labrax/esp32_room_sensors/case/esp32_case_501_preview.png

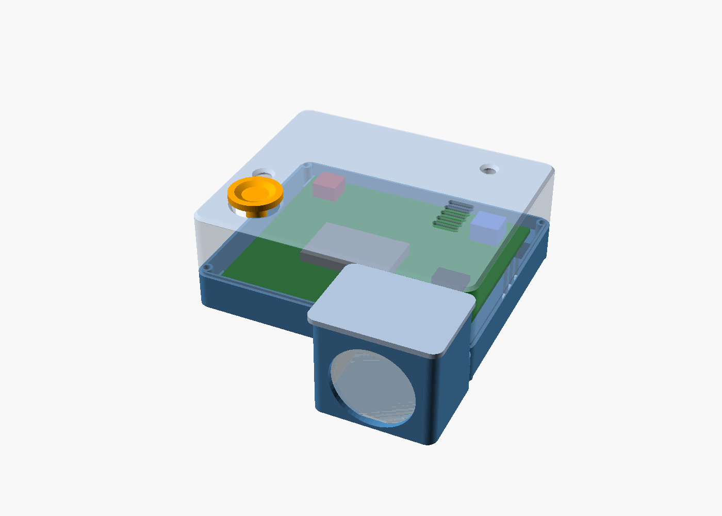
case/esp32_case_501_preview.png
