labrax/esp32_room_sensors/case/esp32_case_ext_preview.png

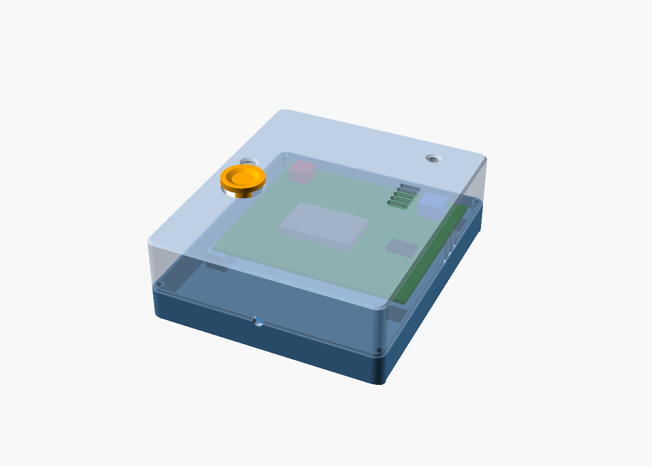
case/esp32_case_ext_preview.png
