labrax/esp32_room_sensors/case/esp32_case_lid_preview.png

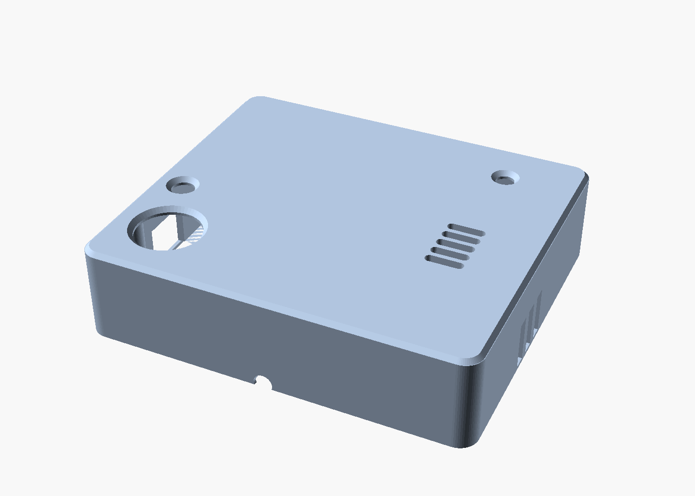
case/esp32_case_lid_preview.png
