labrax/esp32_room_sensors/case/esp32_case_plunger.stl

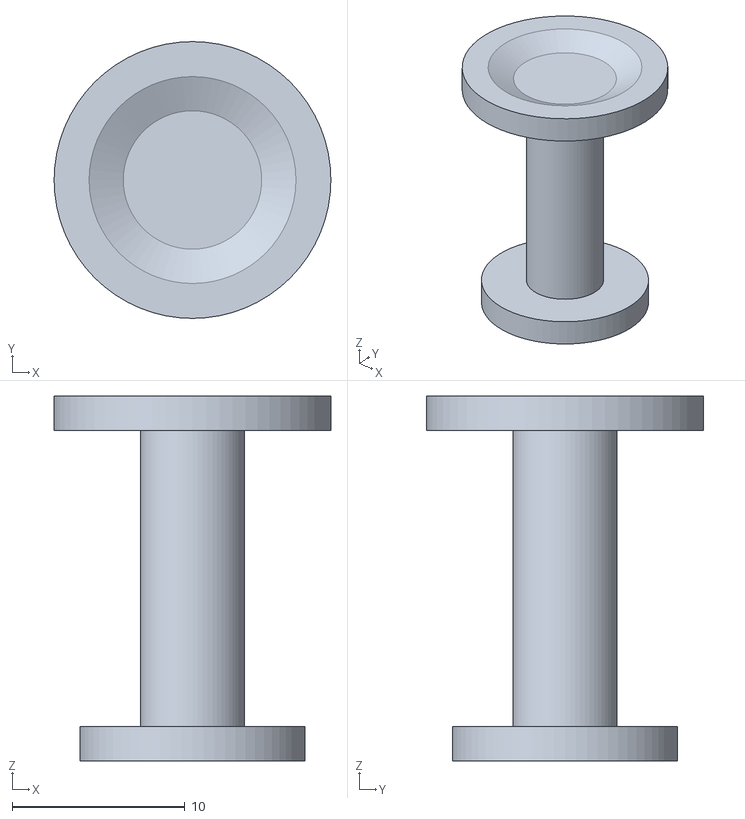
[picture p6: CAD file, 2026-11-05]
case/esp32_case_plunger.stl
16.0 x 16.0 x 21.1
