labrax/esp32_room_sensors/case/esp32_case_lid_pir_ext.stl

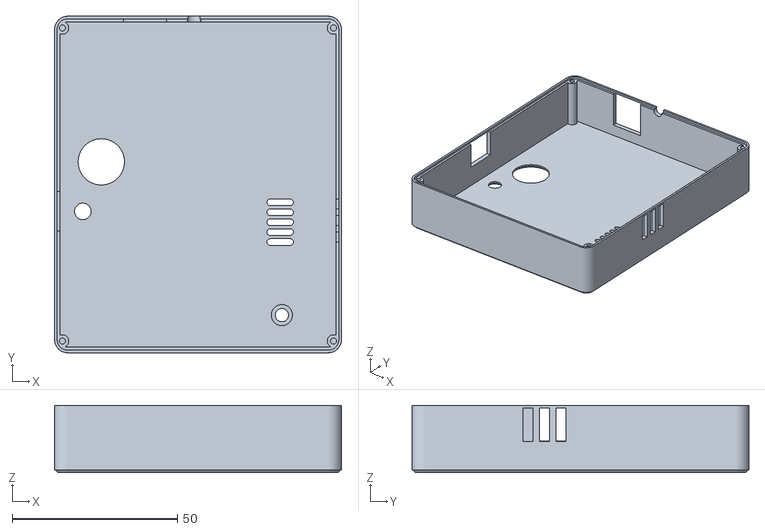
[picture p7: CAD file, 2026-11-05]
case/esp32_case_lid_pir_ext.stl
86.8 x 101.8 x 20.4
