labrax/esp32_room_sensors/case/esp32_case_lid.stl

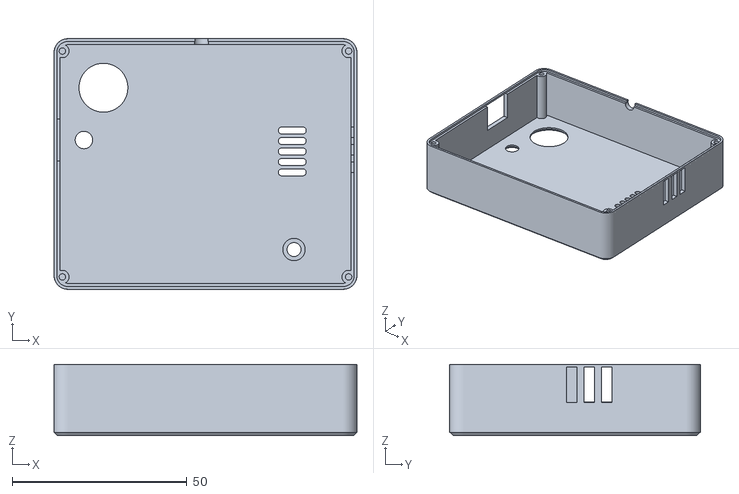
[picture p8: CAD file, 2026-11-05]
case/esp32_case_lid.stl
86.8 x 71.8 x 20.4
