labrax/esp32_room_sensors/case/esp32_case_mic_tube.stl

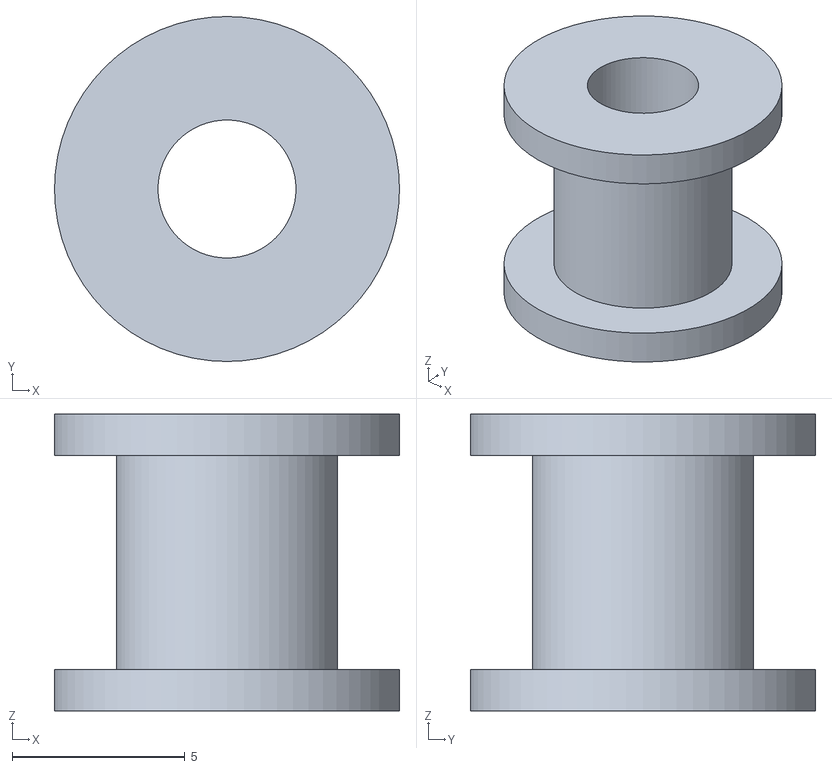
[picture p10: CAD file, 2026-11-05]
case/esp32_case_mic_tube.stl
10.0 x 10.0 x 8.60
