labrax/esp32_room_sensors/case/cases_project.3mf

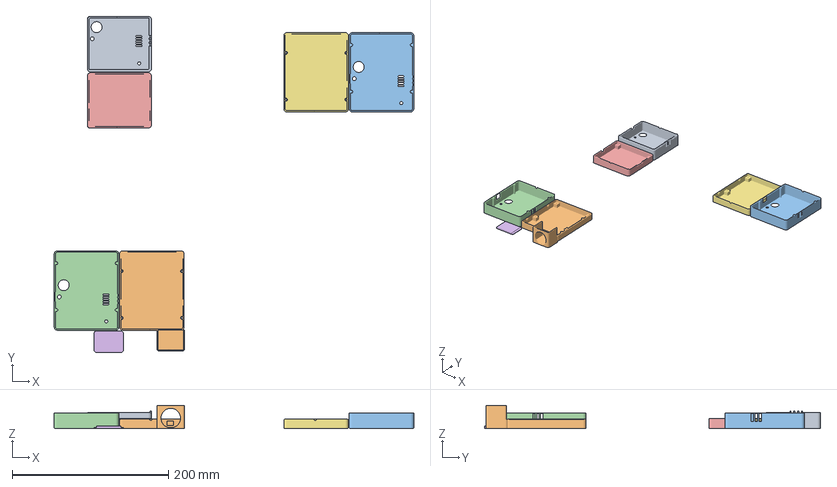
[picture p11: CAD file, 2026-11-04]
case/cases_project.3mf
460.9 x 430.6 x 30.0 mm
esp32_case_lid.stl
esp32_case_base_501_ext.stl
esp32_case_lid_ext.stl
esp32_case_lid_501_ext.stl
esp32_case_base.stl
esp32_case_pir501_cover.stl
esp32_case_base_ext.stl
