labrax/esp32_room_sensors/case/esp32_case_base_501_ext.stl

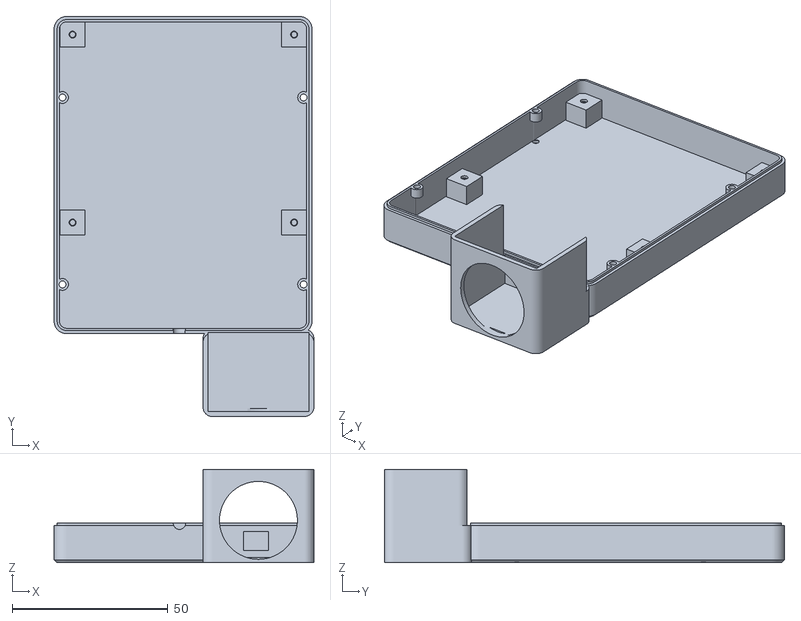
[picture p12: CAD file, 2026-11-04]
case/esp32_case_base_501_ext.stl
83.4 x 128.4 x 30.0
