labrax/esp32_room_sensors/case/esp32_case_base_ext.stl

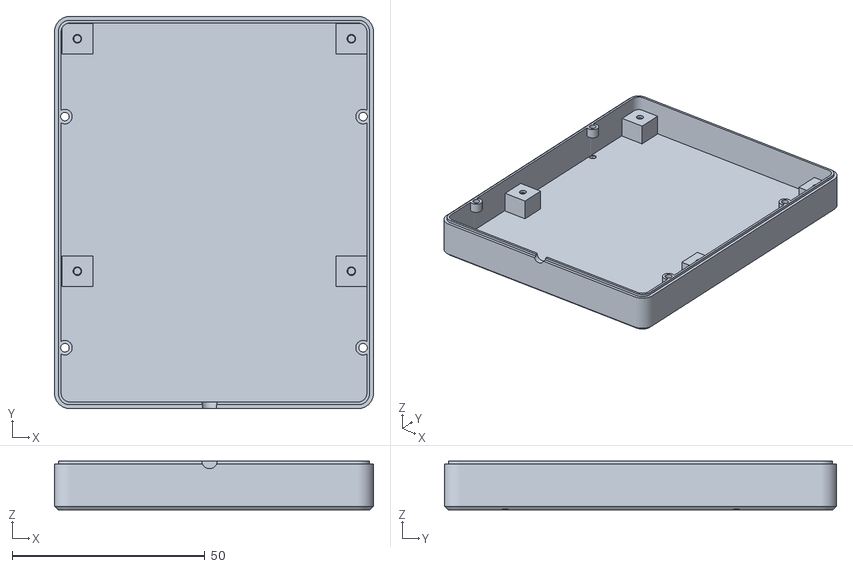
[picture p13: CAD file, 2026-11-04]
case/esp32_case_base_ext.stl
82.8 x 101.8 x 12.7
