labrax/esp32_room_sensors/case/esp32_case_lid_ext.stl

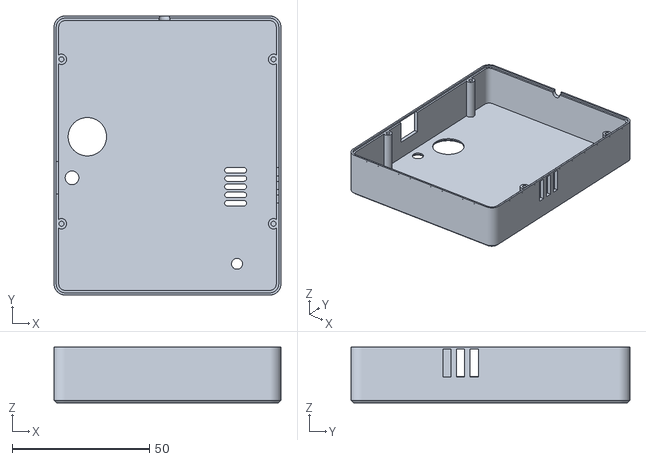
[picture p14: CAD file, 2026-11-04]
case/esp32_case_lid_ext.stl
82.8 x 101.8 x 20.4
