labrax/esp32_room_sensors/case/esp32_case_pir501_cover.stl

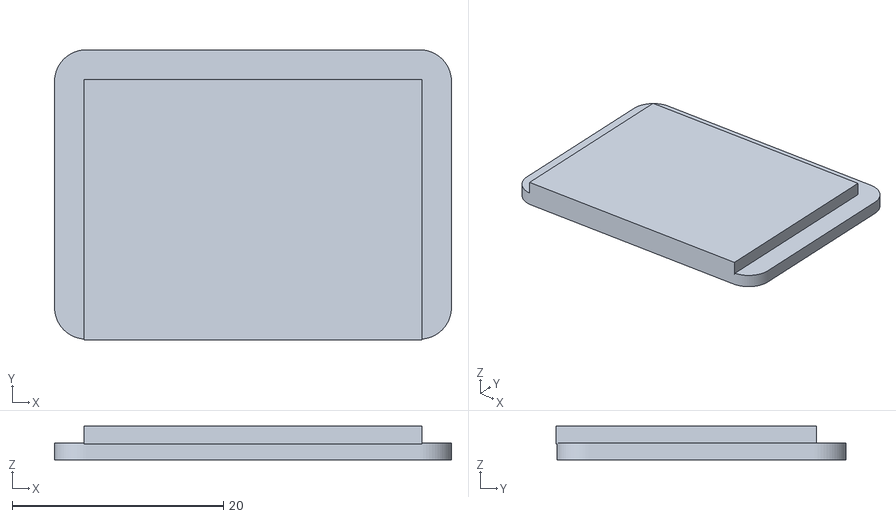
[picture p15: CAD file, 2026-11-04]
case/esp32_case_pir501_cover.stl
37.6 x 27.5 x 3.20
