labrax/esp32_room_sensors/case/esp32_case_lid_pir.stl

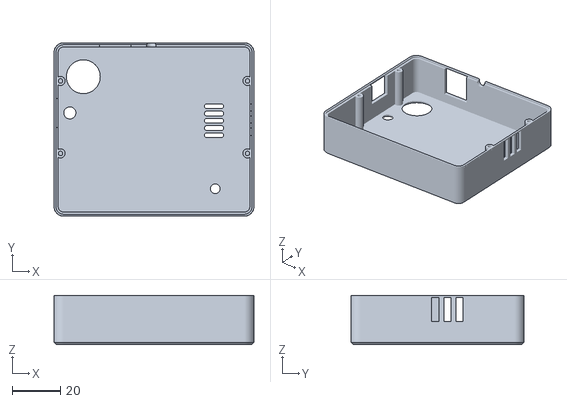
[picture p16: CAD file, 2026-11-04]
case/esp32_case_lid_pir.stl
82.8 x 71.8 x 20.4
