labrax/esp32_room_sensors/case/esp32_case_base.stl

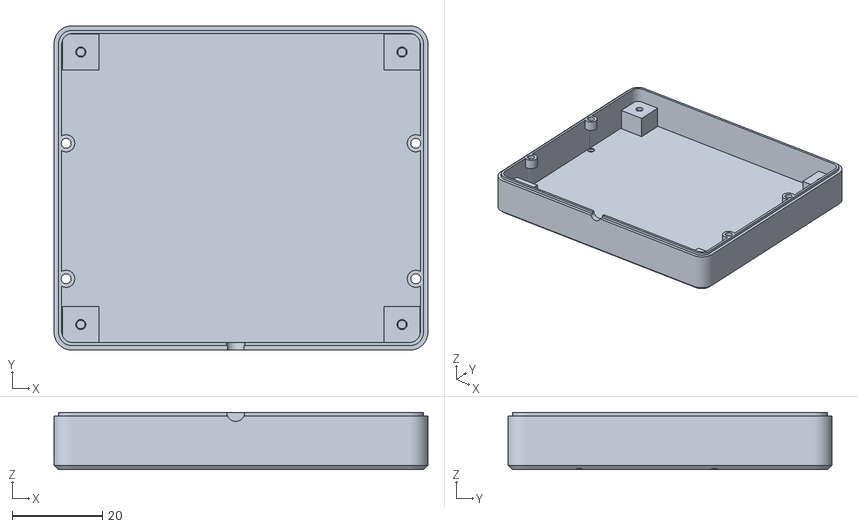
[picture p17: CAD file, 2026-11-04]
case/esp32_case_base.stl
82.8 x 71.8 x 12.7
