labrax/esp32_room_sensors/case/esp32_case_base_501.stl

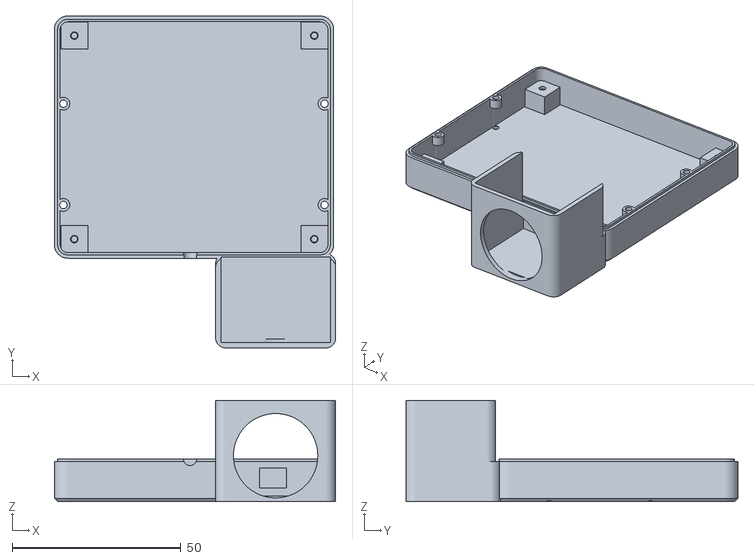
[picture p18: CAD file, 2026-11-04]
case/esp32_case_base_501.stl
83.4 x 98.4 x 30.0
