labrax/esp32_room_sensors/(list of files, cad)

Other CAD files:
case/esp32_case_lid_501.stl
