labrax/esp32_room_sensors/src/esp32_room_sensors/esp32_room_sensors.ino

#include <time.h>

#include "StatusServer.h"
#include "sensors.h"
#include "Mic.h" //mic: useful functions
#include "defines.h" //port definitions
#include "SDData.h"
#include "TimeFunctions.h"
#include "WifiConfig.h"
#include "accel.h"

//task handlers
TaskHandle_t DataTask;
TaskHandle_t DataPIRTask;
TaskHandle_t DataAudioTask;
TaskHandle_t DataAccelTask;
TaskHandle_t InputHandlingTask;

void sensor_data_loop(void * pvParameters) {
  Serial.print("sensor_data_loop() running on core ");
  Serial.println(xPortGetCoreID());
  while(true) {
    delay(1000);
    // collect sensor data
    photoValue = adc1_get_raw(photoPin);
    temperature = bme.readTemperature();
    humidity = bme.readHumidity();
    pressure = bme.readPressure() / 100.0F;

    delay(1000);
    //dust
    digitalWrite(dustLEDPin, HIGH); // power on the LED
    delayMicroseconds(280);
    dustValue = adc1_get_raw(dustPin);
    delayMicroseconds(40);
    digitalWrite(dustLEDPin, LOW); // turn the LED off
    delayMicroseconds(9680);

    status_publish_sensors(temperature, humidity, pressure, dustValue, photoValue);

    // output data
    time_to_file(&data_output);
    Serial.printf("%d,%d,%f,%f,%f\n", dustValue, photoValue, temperature, humidity, pressure);
    if(sd_card == 1) {
      write_n = data_output.printf("%d,%d,%f,%f,%f\n", dustValue, photoValue, temperature, humidity, pressure);
      if(!write_n) {
        sd_card = 0;
      }
      data_output.flush();
    }
    //ets_printf("sensor_data_loop() - never used stack size: %u\n", uxTaskGetStackHighWaterMark(NULL));
    vTaskDelay((SENSOR_TIC_SEC*1000 - 2010)/portTICK_PERIOD_MS);
  }
}

void sensor_pir_data_loop(void * pvParameters) {
  static int npir = 0;
  static bool pir_primed = false;
  while(true) {
    npir = digitalRead(pirPin);
    // The first sample only primes the baseline: an HC-SR501 output that is
    // already high during warm-up is not a trigger.
    if(!pir_primed) {
      pir_primed = true;
      pirValue = npir;
      status_publish_pir(npir, false);
    } else {
      bool pir_triggered = (npir == 1 && pirValue == 0);
      status_publish_pir(npir, pir_triggered);
      if(npir != pirValue) {
        pirValue = npir;
        time_to_file(&data_pir_output);
        Serial.printf("%d\n", pirValue);
        if(sd_card == 1) {
          write_n = data_pir_output.printf("%d\n", pirValue);
          if(!write_n) {
            sd_card = 0;
          }
          data_pir_output.flush();
        }
      }
    }
    //ets_printf("sensor_pir_data_loop() - never used stack size: %u\n", uxTaskGetStackHighWaterMark(NULL));
    vTaskDelay((SENSOR_PIR_TIC_SEC*1000) / portTICK_PERIOD_MS);
  }
}

void input_loop(void * pvParameters) {
  while(true) {
    if(record_streams == 0) {
      digitalWrite(statusLED, HIGH); // power on the LED
      vTaskDelay(250 / portTICK_PERIOD_MS);
      digitalWrite(statusLED, LOW); // power on the LED
      vTaskDelay(250 / portTICK_PERIOD_MS);
      digitalWrite(statusLED, HIGH); // power on the LED
      vTaskDelay(250 / portTICK_PERIOD_MS);
      digitalWrite(statusLED, LOW); // power on the LED
      vTaskDelay(250 / portTICK_PERIOD_MS);
      if(sd_card == 1 && digitalRead(STREAMS_ENABLE_DISABLE_PIN) == HIGH) {
        start_audio_file();
        start_accel_file();
        
        record_streams = 1;
        Serial.println("Streams started");
      }
      vTaskDelay(1000 / portTICK_PERIOD_MS);
    } else { // record_streams == 1
      if(digitalRead(STREAMS_ENABLE_DISABLE_PIN) == HIGH) {
        record_streams = 0;
        Serial.println("Streams stopping");
      }
    }
    vTaskDelay(10 / portTICK_PERIOD_MS);
  }
}

void sensor_accel_loop(void * pvParameters) {
  while(true) {
    if(record_streams == 1 && sd_card == 1) {
      loop_accel(); // internally record_streams is also checked
    } else {
      // No card or idle: publish a ~1 Hz sample instead of opening files.
      float x_g, y_g, z_g;
      if(read_accel_g(&x_g, &y_g, &z_g)) {
        status_publish_accel(x_g, y_g, z_g);
      }
      vTaskDelay(1000 / portTICK_PERIOD_MS);
    }
  }
}

void audio_loop(void * pvParameters) {
  Serial.print("audio_loop() running on core ");
  Serial.println(xPortGetCoreID());
  while(true) {
    if(sd_card == 0) {
      vTaskDelay(1000 / portTICK_PERIOD_MS);
      continue;
    } else if(record_streams == 1) {
      collect_audio_data(); // internally record_streams is also checked
    }
    vTaskDelay(10 / portTICK_PERIOD_MS);

    // intensity
    /*
    time_to_file(&data_audio_output);
    for (int i = 0; i < OCTAVES; i++) {
        //print_level(energy[i]);
        Serial.printf("%d,", (int) energy[i]);

        if(sd_card == 1) {
          write_n = data_audio_output.printf("%d,", (int) energy[i]);
          if(!write_n) {
            sd_card = 0;
          }
        }
    }
    Serial.printf("%.1f\n", loudness);
    if(sd_card == 1) {
      write_n = data_audio_output.printf("%.1f\n", loudness);
      if(!write_n) {
        sd_card = 0;
      }
      data_audio_output.flush();
    }*/
  }
}

void setup() {
  //status info
  pinMode(statusLED, OUTPUT);
  digitalWrite(statusLED, HIGH);
  delay(1000);

  Serial.begin(115200);
  Serial.println();
  Serial.println("#########################################################");
  Serial.printf("Firmware: %s\n", FW_VERSION);
  Serial.printf("Reset reason: %s\n", reset_reason_name());
  Serial.printf("Chip: %s rev %d at %d MHz\n", ESP.getChipModel(),
                ESP.getChipRevision(), ESP.getCpuFreqMHz());
  Serial.printf("Flash: %u bytes, free heap: %u bytes\n",
                ESP.getFlashChipSize(), ESP.getFreeHeap());

  Wire.begin(21, 22, 100000);
  Wire.setTimeOut(50);

  // AP + status page first: init_time() can block in try_ntp() for up to 25 s,
  // and an AP-only boot must still get an AP. With AP_ALWAYS_ON, init_time()
  // keeps WIFI_AP_STA and never turns the radio off.
  btStop(); // BT is unused; keep it off to limit heat next to the BME280
  // Load saved STA credentials before anyone reads them (status page, NTP).
  wifi_config_begin();
  status_server_begin();

  // Time init is the only network step at boot; it is fully bounded.
  init_time();
  Serial.printf("time_source=%s time_valid=%s rtc=%d\n", time_source_name(),
                time_valid ? "true" : "false", rtc_present);

  start_sd();
  Serial.println("starting sensors");
  // sensor setup
  pinMode(dustLEDPin, OUTPUT);
  pinMode(pirPin, INPUT);
  adc1_config_width(ADC_WIDTH_12Bit);
  adc1_config_channel_atten(photoPin, ADC_ATTEN_DB_11);
  adc1_config_channel_atten(dustPin, ADC_ATTEN_DB_11);

  bme_present = bme.begin(0x76);
  Serial.printf("BME280: %s\n", bme_present ? "present" : "missing");

  mpu_present = mpu6050_present_at_0x68();
  if(mpu_present) {
    mpu.Initialize();
  }
  Serial.printf("MPU6050: %s\n", mpu_present ? "present" : "missing");

  start_audio();
  pinMode(STREAMS_ENABLE_DISABLE_PIN, INPUT);

  // Written once per boot, after presence probes, when the SD is mounted.
  write_session_json();

  Serial.println("starting threads");
  //separate thread runnings
  xTaskCreatePinnedToCore(
        audio_loop, /* Function to implement the task */
        "audio_loop", /* Name of the task */
        4096,  /* Stack size in bytes */
        NULL,  /* Task input parameter */
        1,  /* Priority of the task */
        &DataAudioTask,  /* Task handle. */
        0); /* Core where the task should run */

  xTaskCreatePinnedToCore(
        sensor_data_loop, /* Function to implement the task */
        "sensor_loop", /* Name of the task */
        4096,  /* bytes; 1900 B was too small for the float Serial.printf */
        NULL,  /* Task input parameter */
        0,  /* Priority of the task */
        &DataTask,  /* Task handle. */
        1); /* Core where the task should run */

  xTaskCreatePinnedToCore(
        sensor_pir_data_loop, /* Function to implement the task */
        "sensor_pir_loop", /* Name of the task */
        4096,  /* bytes; printf/time_to_file headroom */
        NULL,  /* Task input parameter */
        0,  /* Priority of the task */ 
        &DataPIRTask,  /* Task handle. */
        1); /* Core where the task should run */

  xTaskCreatePinnedToCore(
        input_loop, /* Function to implement the task */
        "input_loop", /* Name of the task */
        4096,  /* Stack size in bytes */
        NULL,  /* Task input parameter */
        0,  /* Priority of the task */ 
        &InputHandlingTask,  /* Task handle. */
        1); /* Core where the task should run */

  xTaskCreatePinnedToCore(
        sensor_accel_loop, /* Function to implement the task */
        "sensor_accel_loop", /* Name of the task */
        4096,  /* Stack size in bytes */
        NULL,  /* Task input parameter */
        0,  /* Priority of the task */ 
        &DataAccelTask,  /* Task handle. */
        1); /* Core where the task should run */

  //status info
  digitalWrite(statusLED, LOW); // power off the LED
}

void loop()
{
  delay(10000);
  service_time();
}
