labrax/esp32_room_sensors/src/esp32_room_sensors/TimeFunctions.h

#ifndef TIMEFUNC_H
#define TIMEFUNC_H
#include <WiFi.h>
#include <RTClib.h> //RTC: DS3231 (raspberry pi-like adapter)
#include "wifi_pass.h"
#include "defines.h"

enum class TimeSource {
  None,
  RTC,
  NTP,
  Compile
};

extern RTC_DS3231 rtc;
extern bool rtc_present;
extern TimeSource time_source;
extern bool time_valid;

// True when an MPU6050 answers at 0x68 (WHO_AM_I == 0x68). The DS3231 shares
// that address, so the RTC probe must not run when this is true.
bool mpu6050_present_at_0x68();

// Boot sequence: probe RTC, fall back to bounded NTP, then compile time.
void init_time();
// Re-read the RTC when it is the active source (called periodically).
void service_time();
void updateTimeFromRTC();

// UTC formatting helpers. `format_timestamp` -> "YYYYMMDD,HH:MM:SS".
void format_timestamp(char *buf, size_t len);
// `format_filename_timestamp` -> "YYYYMMDD_HHMMSS".
void format_filename_timestamp(char *buf, size_t len);
// `format_boot_id` -> "YYYYMMDDTHHMMSSZ-xxxxxx".
void format_boot_id(char *buf, size_t len);

const char *time_source_name();
const char *reset_reason_name();

long current_time();

#endif
