labrax/esp32_room_sensors/src/esp32_room_sensors/Mic.h

#ifndef MIC_H
#define MIC_H

#include <freertos/FreeRTOS.h>
#include <driver/i2s.h> //mic: INMP441
// arduinoFFT is not installed and the FFT block in Mic.cpp is commented out;
// re-add the include and pin the library before enabling it again.
//#include "MicAux.h"
#include "defines.h"
#include "SDData.h"

// setup info
extern int audio_start;

/*
extern int32_t samples[BLOCK_SIZE];
extern size_t num_bytes_read;
extern int samples_read;
extern double loudness;
*/

/*
extern double real[];
extern double imag[];
extern double energy[];
*/

//extern arduinoFFT fft;

void start_audio();
void i2s_adc_data_scale(uint8_t * d_buff, uint8_t* s_buff, uint32_t len);
void i2s_adc(void *arg);

void collect_audio_data();

#endif
