labrax/esp32_room_sensors/src/esp32_room_sensors/ServerFunctions.cpp

#include "ServerFunctions.h"

#ifdef WEBSERVER
WebServer server(80);

void handle_OnConnect() {
  temperature = bme.readTemperature();
  humidity = bme.readHumidity();
  pressure = bme.readPressure() / 100.0F;
  altitude = bme.readAltitude(SEALEVELPRESSURE_HPA);
  server.send(200, "text/html", SendHTML(temperature, humidity, pressure, altitude)); 
}

void handle_NotFound(){
  server.send(404, "text/plain", "Not found");
}

String SendHTML(float temperature, float humidity, float pressure, float altitude){
  String ptr = "<!DOCTYPE html> <html>\n";
  ptr +="<head><meta name=\"viewport\" content=\"width=device-width, initial-scale=1.0, user-scalable=no\">\n";
  ptr +="<title>ESP32 Weather Station</title>\n";
  ptr +="<style>html { font-family: Helvetica; display: inline-block; margin: 0px auto; text-align: center;}\n";
  ptr +="body{margin-top: 50px;} h1 {color: #444444;margin: 50px auto 30px;}\n";
  ptr +="p {font-size: 24px;color: #444444;margin-bottom: 10px;}\n";
  ptr +="</style>\n";
  ptr +="<script>\n";
  ptr +="setInterval(loadDoc,1000);\n";
  ptr +="function loadDoc() {\n";
  ptr +="var xhttp = new XMLHttpRequest();\n";
  ptr +="xhttp.onreadystatechange = function() {\n";
  ptr +="if (this.readyState == 4 && this.status == 200) {\n";
  ptr +="document.body.innerHTML =this.responseText}\n";
  ptr +="};\n";
  ptr +="xhttp.open(\"GET\", \"/\", true);\n";
  ptr +="xhttp.send();\n";
  ptr +="}\n";
  ptr +="</script>\n";
  ptr +="</head>\n";
  ptr +="<body>\n";
  ptr +="<div id=\"webpage\">\n";
  ptr +="<h1>ESP32 Weather Station</h1>\n";
  ptr +="<p>Temperature: ";
  ptr +=temperature;
  ptr +="&deg;C</p>";
  ptr +="<p>Humidity: ";
  ptr +=humidity;
  ptr +="%</p>";
  ptr +="<p>Pressure: ";
  ptr +=pressure;
  ptr +="hPa</p>";
  ptr +="<p>Altitude: ";
  ptr +=altitude;
  ptr +="m</p>";
  ptr +="</div>\n";
  ptr +="</body>\n";
  ptr +="</html>\n";
  return ptr;
}
#endif
