labrax/esp32_room_sensors/(commit log)

2021-04-07 improved delay between threads; mic disable jumper
2021-07-17 increase sensor data collection delay
2021-07-17 raw audio signal collection; using button to control recording
2021-07-17 RTC time skip; renamed button; tasks for accel, input; modified audio loop
    [TimeFunctions.cpp, TimeFunctions.h, defines.h, esp32_room_sensors.ino]
2026-11-04 Add case, PCB, and tools
2026-11-04 Update slicer project and organize PCB source
2026-11-04 Move firmware sketch into src/esp32_room_sensors and stop tracking wifi credentials
2026-11-04 Add pinned Arduino build profile and CI gate
    HS-9. Reproducible firmware build per architecture decision D5.
    - src/esp32_room_sensors/sketch.yaml: profile esp32 (esp32:esp32 2.0.17
    from the Espressif index) with the five pinned libraries; default_profile.
    - .github/workflows/ci.yml: firmware job (arduino-cli 1.5.1, cached core and
    libraries, pinned core + libraries, wifi_pass.h from the example, profile
    compile) and guards job (tracked-but-ignored files must be empty, codespell).
    The case and tools jobs land with HS-10/HS-11.
    - .codespellrc: skip binaries/worktree lanes, small ignore list for existing
    false positives and one firmware comment typo left to the runtime ticket.
    - Mic.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
2026-11-04 Add always-on WiFi AP with a status page and JSON API (HS-12)
    AP+STA at boot: WPA2, channel 1, four clients, 192.168.4.1/24. The STA
    interface stays up for NTP instead of being turned off after the time sync.
    - StatusServer: GET / (HTML) and GET /api/status (JSON) with sensors,
    time source/validity, SD state, recording state, uptime, and WiFi.
    The sensor task publishes a SensorSnapshot under a mutex; the handlers
    copy it and never touch I2C. Own task on core 1, priority 1, 8192 B,
    handleClient() every 10 ms.
    - AP_SSID/AP_PASSWORD in wifi_pass.h (example documents them); the build
    fails on a WPA2 key shorter than 8 characters.
    - AP_ALWAYS_ON (default 1) in defines.h; BME280 heat bi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
2026-11-04 Firmware: bounded boot with RTC/NTP/compile time sources (HS-4)
    Remove SKIP_RTC and probe the DS3231 at runtime (begin, lostPower,
    year 2024-2100), re-reading it hourly when it is the active source.
    Bound the WiFi connect to 15 s and NTP sync to 10 s, turn the radio off
    after the sync attempt, and drop btStop. Fall back to __DATE__/__TIME__
    parsed as UTC with time_valid=false. Set TZ=UTC0.
    Add format_timestamp/format_filename_timestamp/format_boot_id helpers
    using localtime_r+strftime and remove the shared a0/a1/current_tm and
    tick_time_update state. Fix updateTimeFromRTC to zero the struct tm,
    set tm_isdst=0 and use mktime.
    Write one /<timestamp>_session.json per boot with firmware versio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
2026-11-04 Add HS-3 microphone bench harness and MIC1 test tube
    Standalone ESP32/INMP441/SD WAV recorder, stdlib-only WAV comparison and sweep generator, a 16 mm 4 mm-ID tube test part, and the bench protocol. Physical measurements are pending; no firmware or production case changes.
2026-11-04 Document the MPU/RTC address conflict and probe order
2026-11-04 CI: update actions to node24 and pin ubuntu-24.04
    - actions/checkout v4 -> v7, actions/cache v4 -> v6, actions/setup-python v5 -> v7
    - replace arduino/setup-arduino-cli@v2 (node20 only) with a pinned
    manual Arduino CLI 1.5.1 install
    - pin runs-on to ubuntu-24.04 to avoid the ubuntu-latest migration notice
2026-11-04 Record the HS-3 sealed-hole C result
2026-11-04 Add AP WiFi provisioning form (HS-12)
    Store STA credentials in NVS behind a commit marker, expose a WiFi
    form on the AP status page, and use the saved pair for NTP. Input is
    printable-ASCII only; the password is never rendered or logged. The
    AP stays up; wrong credentials fall back to RTC/compile time.
2026-11-05 Add no-print tube alternatives to the HS-3 protocol
2026-11-05 Size the HS-3 mic tube to the measured 8.6 mm gap
2026-11-05 Widen case 2 mm per side and move lid screws outward
2026-11-05 Record the HS-3 tube E and null results
2026-11-05 Move lid screws to case corners
2026-11-05 Record the HS-3 tube decision and prepare the merge
2026-11-05 Add INMP441 acoustic tube to lid
2026-11-05 Integrate the lid tube with the HS-3 test harness
2026-11-05 Raise sensor loop stack to 4 KiB for float printf (HS-12)
    The first post-merge flash panicked with a stack-canary watchpoint in
    sensor_data_loop during Serial.printf("%d,%d,%f,%f,%f"). addr2line
    placed it in _dtoa_r/vsnprintf; the 1900-byte task stack was too small.
    Use 4096 bytes like the other logging tasks and correct the stack-unit
    comments. Verified by reflashing and a 38 s boot/monitor capture.
2026-11-06 Run without SD and expose CSV sensors over AP (HS-12)
    Remove the loop restart when no card is mounted, guard SD file opens,
    and keep all CSV/audio/accel writes behind sd_card. Publish dust, light,
    PIR, and MPU6050 acceleration in the status snapshot, /api/status, and
    the AP page alongside the BME280 values. Audio remains SD-only; the
    SD-present logging paths are unchanged.
2026-11-06 Show PIR as motion on D35 (HS-12)
    The PIR is fitted on D35; present its digital level as motion/clear on
    the AP page instead of a raw pin-level label, and align the README and
    architecture notes with the fitted sensor.
2026-11-06 Show last PIR trigger on the AP page (HS-12)
    Track the last 0->1 PIR edge in the status snapshot, expose
    pir_last_trigger_age_ms in /api/status, and render a Last trigger row
    (N s ago / none since boot) next to Motion (D35). Prime the first PIR
    sample so an HC-SR501 boot-high warm-up is not a false trigger.
